HexabitzPlatform/H3BR7x-Hardware/README.md

# H3BR7x-Hardware
Hexabitz 6-Digit 7-Segment Red Display Module Hardware Design
