HexabitzPlatform/H3BR7x-Hardware/Rleased/BOM/H3BR7.xlsx

 |  | www.hexabitz.com info@hexabitz.com |  | Bill Of Materials
Customer | Hexabitz | Revision | 0
Project | Hexabitz Modules | Date | 2024-02-10
Board | 6-Digit 7-Segment Red Display Module (H3BR7) | Notes
Designator | Description | Manufacturer Part Number | Manufacturer | Octopart Url | Quantity
R | Headers & Wire Housings Unshrouded 1 POS T/H | 5-146280-1 | TE Connectivity | https://octopart.com/5-146280-1-te+connectivity+%2F+amp-40259676?r=sp | 1
SWD | Conn Unshrouded Header HDR 3 POS 2.54mm Solder ST Top Entry Thru-Hole Carton | 5-146281-3 | TE Connectivity | https://octopart.com/5-146281-3-te+connectivity+%2F+amp-39745942?r=sp (https://octopart.com/c0603c104k8ractu-kemet-145075?r=sp&s=9bS9ASSwSEqMCE9KBEQZ0g) | 1
R2 | RES SMD 0.0OHM JUMPER 1/10W 0603 | RC0603JR-070RL | YAGEO [VR] | https://octopart.com/rc0603jr-070rl-yageo-1241539?r=sp (https://octopart.com/10tpu4r7msi-panasonic-29487748?r=sp) | 1
R12, R13, R14, R15, R16, R17, R18, R19, R27, R28, R29, R30 | RES SMD 100 OHM 5% 1/10W 0603 | RC0603FR-07100RL | Yageo | https://octopart.com/rc0603fr-07100rl-yageo-55402879?r=sp (https://octopart.com/cl05a106mp8nub8-samsung-68086897?r=sp) | 12
R3 | Thick Film Resistors - SMD 0603 270ohms 5% Tol | ERJ-3GEYJ271V | Panasonic | https://octopart.com/erj-3geyj271v-panasonic-55560546?r=sp (https://octopart.com/rc0603jr-070rl-yageo-1241539?r=sp) | 1
R1, R4, R5, R6, R7, R8, R9, R11, R20, R21, R22, R23, R24, R25, R26 | RES 10 K OHM 5% 0603 | CRCW060310K0JNEB | Vishay | https://octopart.com/crcw060310k0jneb-vishay-46603269 (https://octopart.com/erj-3geyj271v-panasonic-55560546) | 15
C1, C3, C5, C6 | CAP CER 0.1uF 10% x7R 0603 10V | C0603C104K8RACTU | KEMET | https://octopart.com/c0603c104k8ractu-kemet-145075?r=sp&s=9bS9ASSwSEqMCE9KBEQZ0g | 4
C4 | CAP CER 1UF 16V X7R 0805 | CC0805KKX7R7BB105 | YAGEO [VA] | https://octopart.com/cc0805kkx7r7bb105-yageo-8376555?r=sp | 1
C2, C7 | CAP TANT 4.7UF 10V 20% 0805 | 10TPU4R7MSI | Panasonic | https://octopart.com/10tpu4r7msi-panasonic-29487748?r=sp | 2
FB1 | Ind chip Bead Multi-Layer 30 ohms 25% 100MHZ Ferrite 1,5A 0603Punched paper T/R | MMZ1608Y300BTA00 | TDK | https://octopart.com/mmz1608y300bta00-tdk-7906990?r=sp (https://octopart.com/search?q=RC0603FR-0710KL&currency=USD&specs=0) | 1
D1 | Red 0603 130آ° Clear 54 mcd 2 V Surface Mount ChipLED ; | VLMS1300-GS08 (https://octopart.com/manufacturers/wolfspeed) | Vishay | https://octopart.com/vlms1300-gs08-vishay-21709201?r=sp&s=0nXJNjGsSbWwqfqWlZv0EA | 1
D2 | TVS DIODE 3,3V 10,9V SOD323 | CDSOD323-T03SC | BOURNS INC | https://octopart.com/cdsod323-t03sc-bourns-10487153?r=sp | 1
LED1, LED2, LED3, LED4 | LED 3mm RED Collor | TLHK4600 | Vishay | https://octopart.com/tlhk4600-vishay-39410044?r=sp (https://octopart.com/87227-1-te+connectivity-39512052?r=sp) | 4
Q1, Q2, Q3, Q4, Q5, Q6 | Trans GP BJT PNP 40V 0.2A 330mW Automotive 3-Pin SOT-23 T/R | MMBT3906LT1HTSA1 | Infineon | https://octopart.com/mmbt3906lt1htsa1-infineon-21387160?r=sp | 6
Q7, Q8, Q9, Q10, Q11, Q12, Q13, Q14 | Transistor, Bipolar, Si, NPN, General Purpose, VCEO 40VDC, IC 200mA, PD 225mW, SOT-23 | MMBT3904LT1G | ON Semiconductor | https://octopart.com/mmbt3904lt1g-on+semiconductor-3280?r=sp | 8
3661BS | 0.36 inch 6digits RED 8 segment led display Common Anode | 3661BS | China | https://www.aliexpress.com/item/1326420858.html (https://octopart.com/search?q=060300F2201T5E&currency=USD&specs=0) | 1
U1 | MCU 32-Bit ARM Cortex-M0+ RISC 512kByte Flash 1.7V to 3.6V 48-Pin UFQFPN Tray | STM32G0B1CEU6N | STMicroelectronics | https://octopart.com/stm32g0b1ceu6n-stmicroelectronics-116364672?r=sp (https://octopart.com/search?q=MPZ1608S601ATD25&currency=USD&specs=0) | 1
X1 | 8,0000MHZ 33pF SMD MURATA Resonators | CSTNE8M00G550000R0 | Murata | https://octopart.com/cstne8m00g550000r0-murata-91406934?r=sp (https://octopart.com/stm32g0b1ceu6n-stmicroelectronics-116364672?r=sp) | 1
