HexabitzPlatform/H3BR7x-Hardware/Documentation/H3BR7 Schematics.pdf

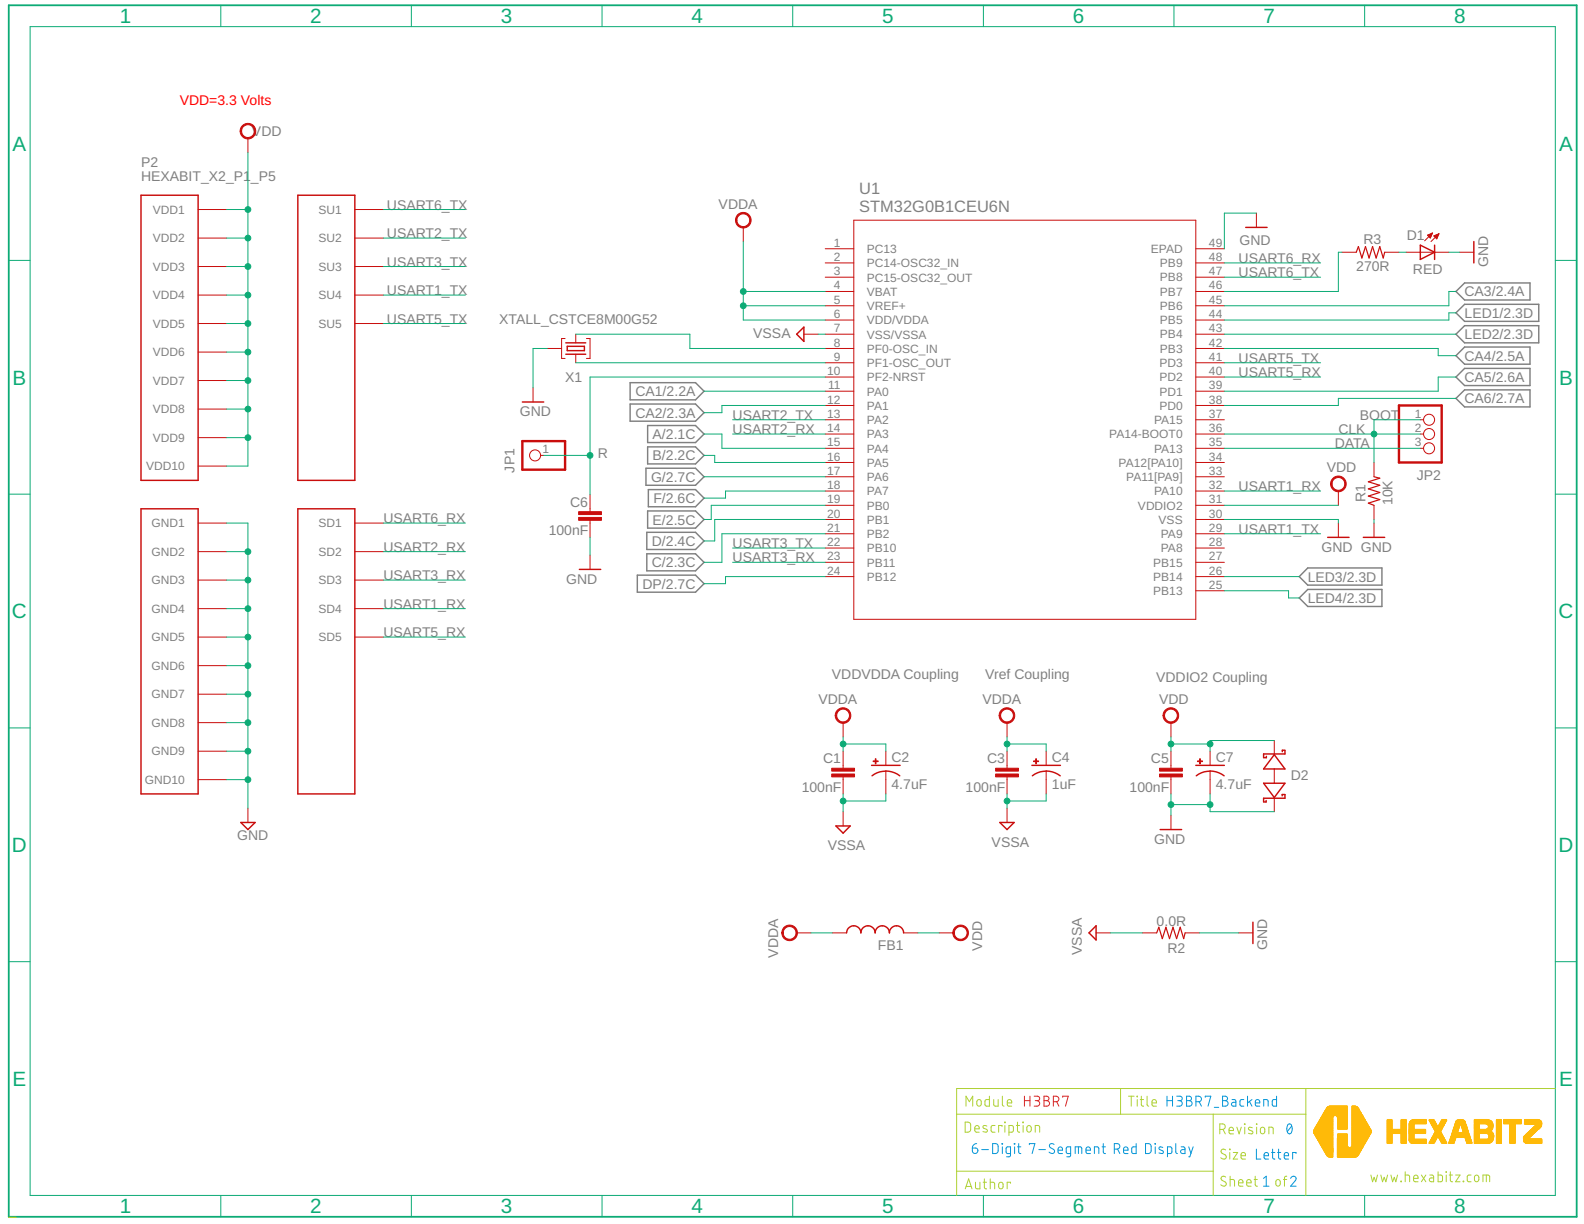
[picture p1: page 1]

5 | 45 PB7
6 | 44 PB6

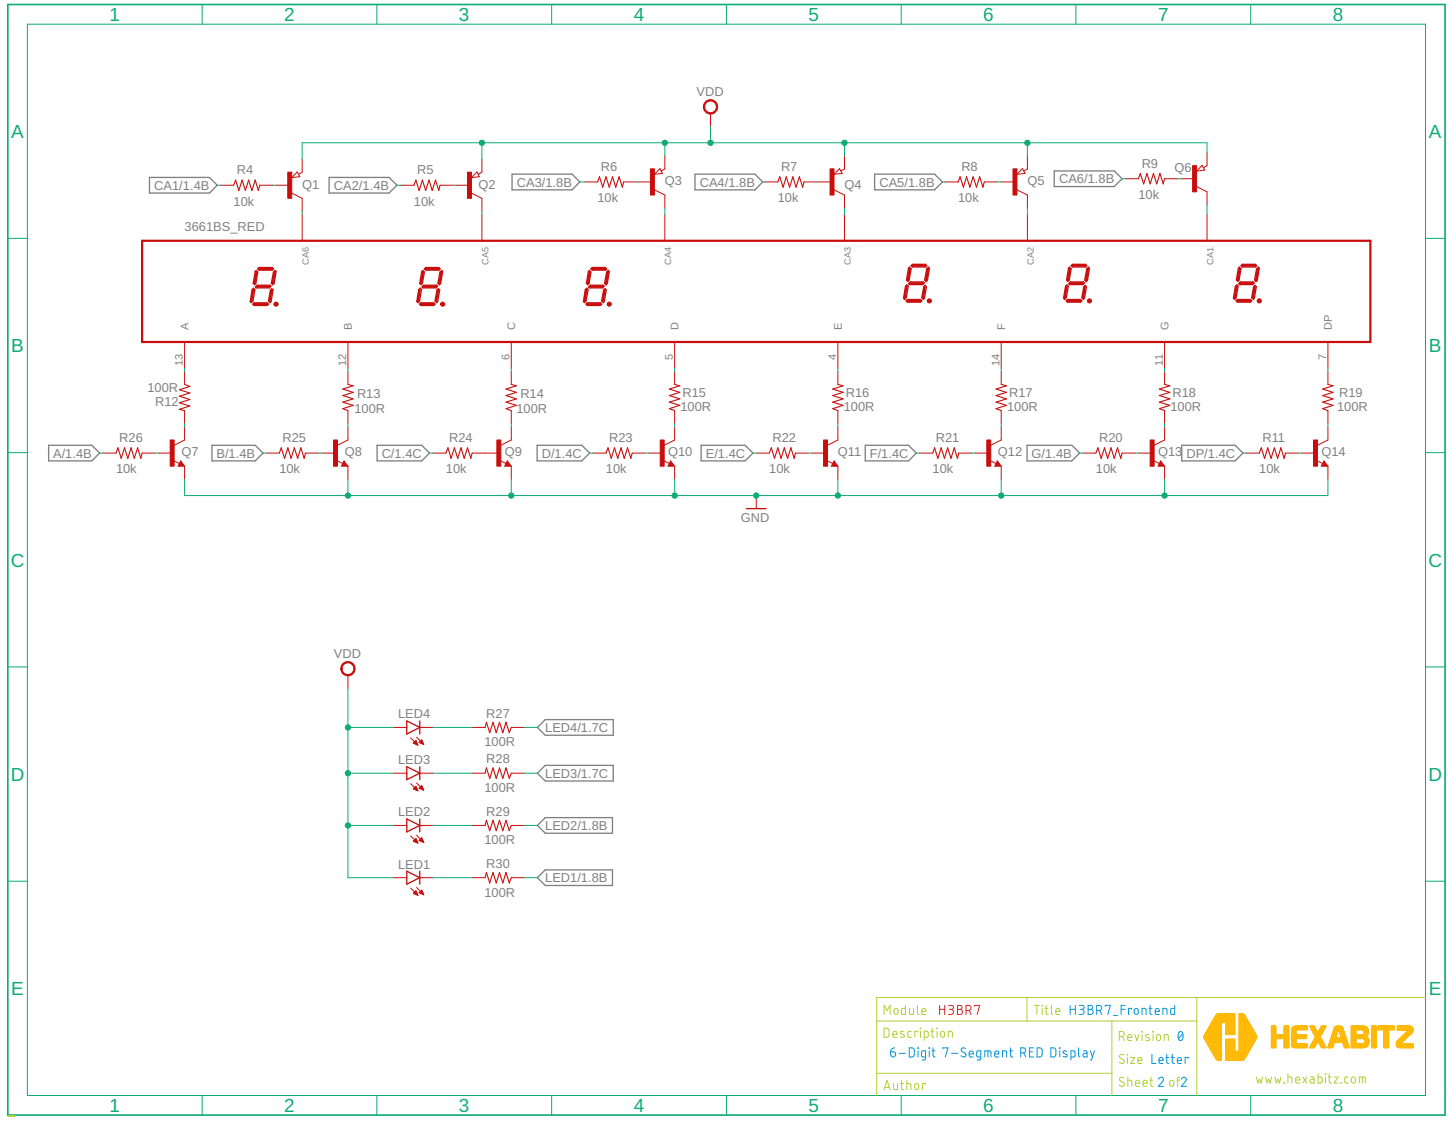
[picture p2: page 2]
