HexabitzPlatform/H3BR7x-Hardware/Design/H3BR7.brd

## EAGLE design Design/H3BR7.brd (2024-04-25)

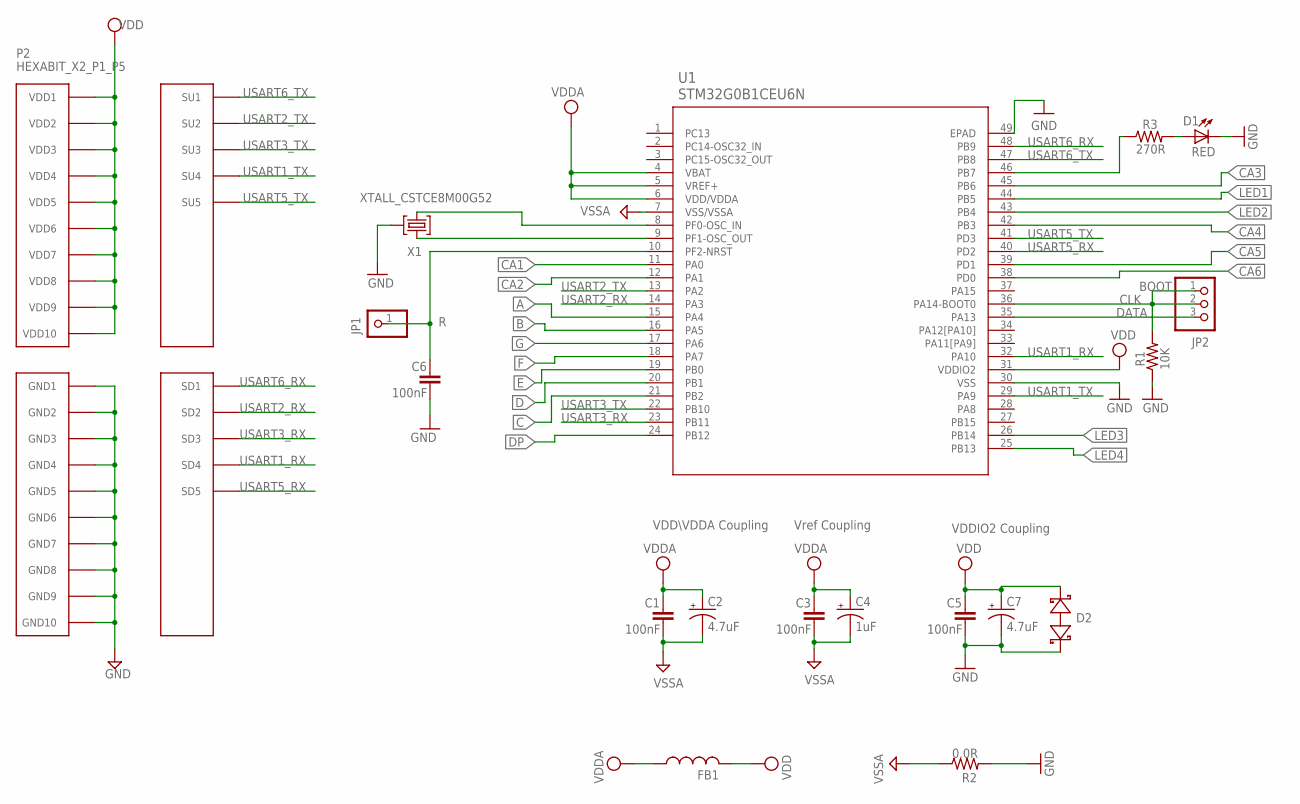
[picture p3: schematic H3BR7.sch, sheet 1]

Parts:
C1, C3, C5, C6: 100nF; C-0603
C2, C7: 4.7uF; C-0805-POL
C4: 1uF; C-0805-POL
D1: RED; VLMS1300-GS08; MPN VLMS1300-GS08
D2: BOURNS_CDSOD323-T03SCBOURNS_CDSOD323-T03SC_0_0; BOURNS_CDSOD323-T03SC_0
FB1: FB-0603
JP1: R; 1X01
JP2: PINHD-1X3; 1X03
P2: HEXABIT_X2_P1_P5; HEXABIT_17.32_X2_P1_P5
R1: 10K; R-0603
R2: 0.0R; R-0603
R3: 270R; R-0603
U1: STM32G0B1CEU6N; HEXABITZ_ICS_QFN_B1CEU6_STM-L
X1: XTALL_CSTCE8M00G52

Connections:
A: U1.15 (PA4); also elsewhere on the board
B: U1.16 (PA5); also elsewhere on the board
C: U1.21 (PB2); also elsewhere on the board
CA1: U1.11 (PA0); also elsewhere on the board
CA2: U1.12 (PA1); also elsewhere on the board
CA3: U1.45 (PB6); also elsewhere on the board
CA4: U1.42 (PB3); also elsewhere on the board
CA5: U1.39 (PD1); also elsewhere on the board
CA6: U1.38 (PD0); also elsewhere on the board
CLK: JP2.1, JP2.2, R1.2, U1.36 (PA14-BOOT0)
D: U1.20 (PB1); also elsewhere on the board
DATA: JP2.3, U1.35 (PA13)
DP: U1.24 (PB12); also elsewhere on the board
E: U1.19 (PB0); also elsewhere on the board
F: U1.18 (PA7); also elsewhere on the board
G: U1.17 (PA6); also elsewhere on the board
GND: C5.2, C6.2, C7.2 (-), D1.C, D2.1 (A), P2.PAD_PD11 (GND1), P2.PAD_PD12 (GND2), P2.PAD_PD13 (GND3), P2.PAD_PD14 (GND4), P2.PAD_PD15 (GND5), P2.PAD_PD16 (GND6), P2.PAD_PD17 (GND7), P2.PAD_PD18 (GND8), P2.PAD_PD19 (GND9), P2.PAD_PD20 (GND10), R1.1, R2.2, U1.30 (VSS), U1.49 (EPAD), X1.P$2 (2); also elsewhere on the board
LED1: U1.44 (PB5); also elsewhere on the board
LED2: U1.43 (PB4); also elsewhere on the board
LED3: U1.26 (PB14); also elsewhere on the board
LED4: U1.25 (PB13); also elsewhere on the board
unnamed: D1.A, R3.2
unnamed: R3.1, U1.46 (PB7)
unnamed: U1.9 (PF1-OSC_OUT), X1.P$1 (1)
unnamed: U1.8 (PF0-OSC_IN), X1.P$3 (3)
unnamed: C6.1, JP1.1, U1.10 (PF2-NRST)
USART1_RX: P2.PAD_PD4 (SD4), U1.32 (PA10)
USART1_TX: P2.PAD_PU4 (SU4), U1.29 (PA9)
USART2_RX: P2.PAD_PD2 (SD2), U1.14 (PA3)
USART2_TX: P2.PAD_PU2 (SU2), U1.13 (PA2)
USART3_RX: P2.PAD_PD3 (SD3), U1.23 (PB11)
USART3_TX: P2.PAD_PU3 (SU3), U1.22 (PB10)
USART5_RX: P2.PAD_PD5 (SD5), U1.40 (PD2)
USART5_TX: P2.PAD_PU5 (SU5), U1.41 (PD3)
USART6_RX: P2.PAD_PD1 (SD1), U1.48 (PB9)
USART6_TX: P2.PAD_PU1 (SU1), U1.47 (PB8)
VDD: C5.1, C7.1 (+), D2.2 (C), FB1.2, P2.PAD_PU11 (VDD1), P2.PAD_PU12 (VDD2), P2.PAD_PU13 (VDD3), P2.PAD_PU14 (VDD4), P2.PAD_PU15 (VDD5), P2.PAD_PU16 (VDD6), P2.PAD_PU17 (VDD7), P2.PAD_PU18 (VDD8), P2.PAD_PU19 (VDD9), P2.PAD_PU20 (VDD10), U1.31 (VDDIO2); also elsewhere on the board
VDDA: C1.1, C2.1 (+), C3.1, C4.1 (+), FB1.1, U1.4 (VBAT), U1.5 (VREF+), U1.6 (VDD/VDDA)
VSSA: C1.2, C2.2 (-), C3.2, C4.2 (-), R2.1, U1.7 (VSS/VSSA)

Notes on the sheet:
Vref Coupling
VDDIO2 Coupling
VDD\VDDA Coupling
BOOT

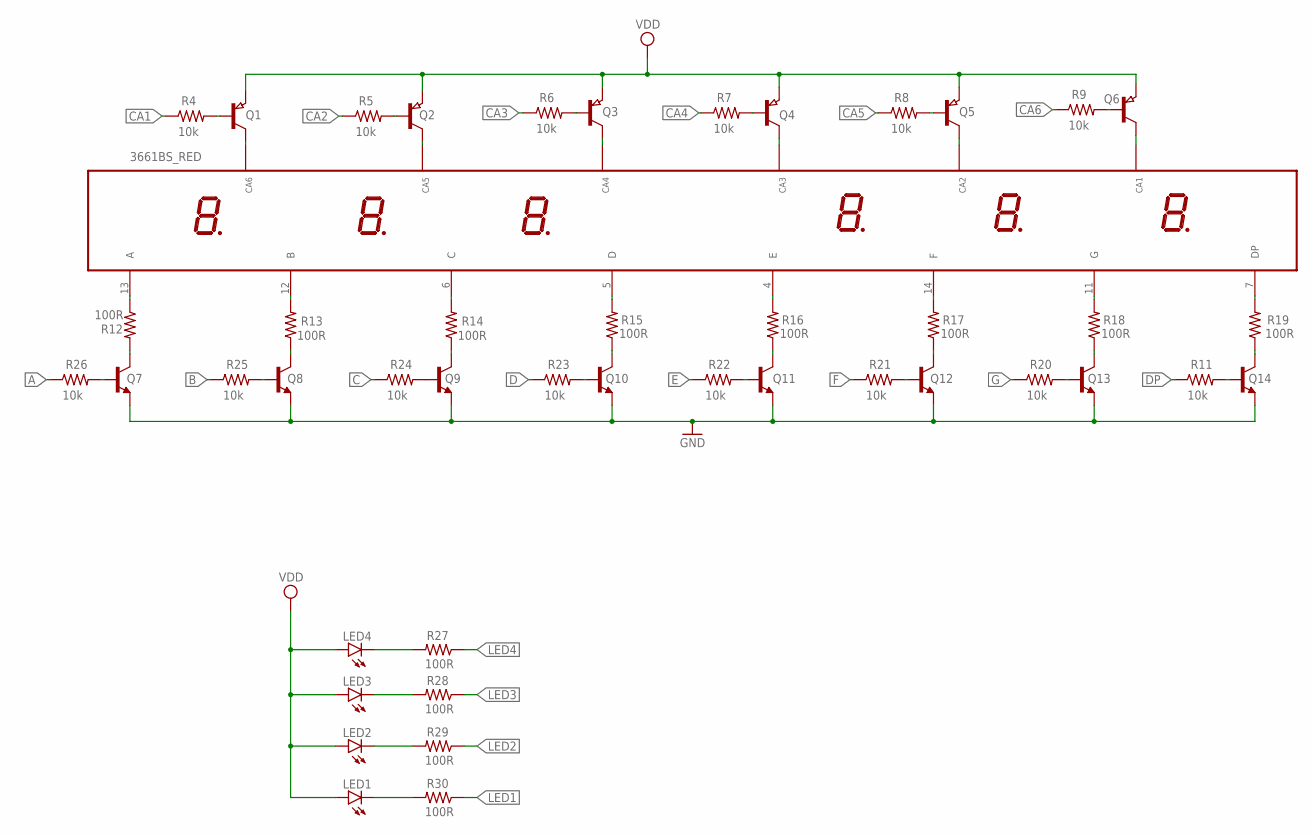
[picture p4: schematic H3BR7.sch, sheet 2]

Parts:
3661BS: 3661BS_RED; 3661BS
LED1, LED2, LED3, LED4: LED-3MM3MM; LED3MM
Q1, Q2, Q3, Q4, Q5, Q6: SEMICON-SMD-IPC_PNP-TRANSISTOR_SOT23; SEMICON-SMD-IPC_SOT23
Q7, Q8, Q9, Q10, Q11, Q12, Q13, Q14: MMBT3904LT1
R4, R5, R6, R7, R8, R9, R11, R20, R21, R22, R23, R24, R25, R26: 10k; R-0603
R12, R13, R14, R15, R16, R17, R18, R19, R27, R28, R29, R30: 100R; R-0603
TRIMBLE-LOGO1: HEXA-LOGO

Connections:
A: R26.1; also elsewhere on the board
B: R25.1; also elsewhere on the board
C: R24.1; also elsewhere on the board
CA1: R4.1; also elsewhere on the board
CA2: R5.1; also elsewhere on the board
CA3: R6.1; also elsewhere on the board
CA4: R7.1; also elsewhere on the board
CA5: R8.1; also elsewhere on the board
CA6: R9.1; also elsewhere on the board
D: R23.1; also elsewhere on the board
DP: R11.1; also elsewhere on the board
E: R22.1; also elsewhere on the board
F: R21.1; also elsewhere on the board
G: R20.1; also elsewhere on the board
GND: Q7.2 (E), Q8.2 (E), Q9.2 (E), Q10.2 (E), Q11.2 (E), Q12.2 (E), Q13.2 (E), Q14.2 (E); also elsewhere on the board
LED1: R30.1; also elsewhere on the board
LED2: R29.1; also elsewhere on the board
LED3: R28.1; also elsewhere on the board
LED4: R27.1; also elsewhere on the board
unnamed: 3661BS.13 (A), R12.1
unnamed: Q7.1 (B), R26.2
unnamed: Q8.3 (C), R13.1
unnamed: 3661BS.6 (C), R14.2
unnamed: Q8.1 (B), R25.2
unnamed: Q9.1 (B), R24.2
unnamed: Q10.1 (B), R23.2
unnamed: Q11.1 (B), R22.2
unnamed: Q12.1 (B), R21.2
unnamed: Q13.1 (B), R20.2
unnamed: Q14.1 (B), R11.2
unnamed: Q10.3 (C), R15.1
unnamed: 3661BS.5 (D), R15.2
unnamed: Q11.3 (C), R16.1
unnamed: Q13.3 (C), R18.1
unnamed: 3661BS.11 (G), R18.2
unnamed: Q7.3 (C), R12.2
unnamed: LED4.K (C), R27.2
unnamed: LED3.K (C), R28.2
unnamed: Q1.1 (B), R4.2
unnamed: Q2.1 (B), R5.2
unnamed: Q3.1 (B), R6.2
unnamed: Q4.1 (B), R7.2
unnamed: Q5.1 (B), R8.2
unnamed: Q6.1 (B), R9.2
unnamed: 3661BS.1 (CA), Q6.3 (C)
unnamed: LED2.K (C), R29.2
unnamed: LED1.K (C), R30.2
unnamed: 3661BS.8 (CA), Q1.3 (C)
unnamed: 3661BS.9 (CA), Q2.3 (C)
unnamed: 3661BS.10 (CA), Q3.3 (C)
unnamed: 3661BS.3 (CA), Q4.3 (C)
unnamed: 3661BS.2 (CA), Q5.3 (C)
unnamed: 3661BS.7 (DP), R19.2
unnamed: Q14.3 (C), R19.1
unnamed: 3661BS.4 (E), R16.2
unnamed: 3661BS.14 (F), R17.2
unnamed: 3661BS.12 (B), R13.2
unnamed: Q12.3 (C), R17.1
unnamed: Q9.3 (C), R14.1
VDD: LED1.A, LED2.A, LED3.A, LED4.A, Q1.2 (E), Q2.2 (E), Q3.2 (E), Q4.2 (E), Q5.2 (E), Q6.2 (E); also elsewhere on the board

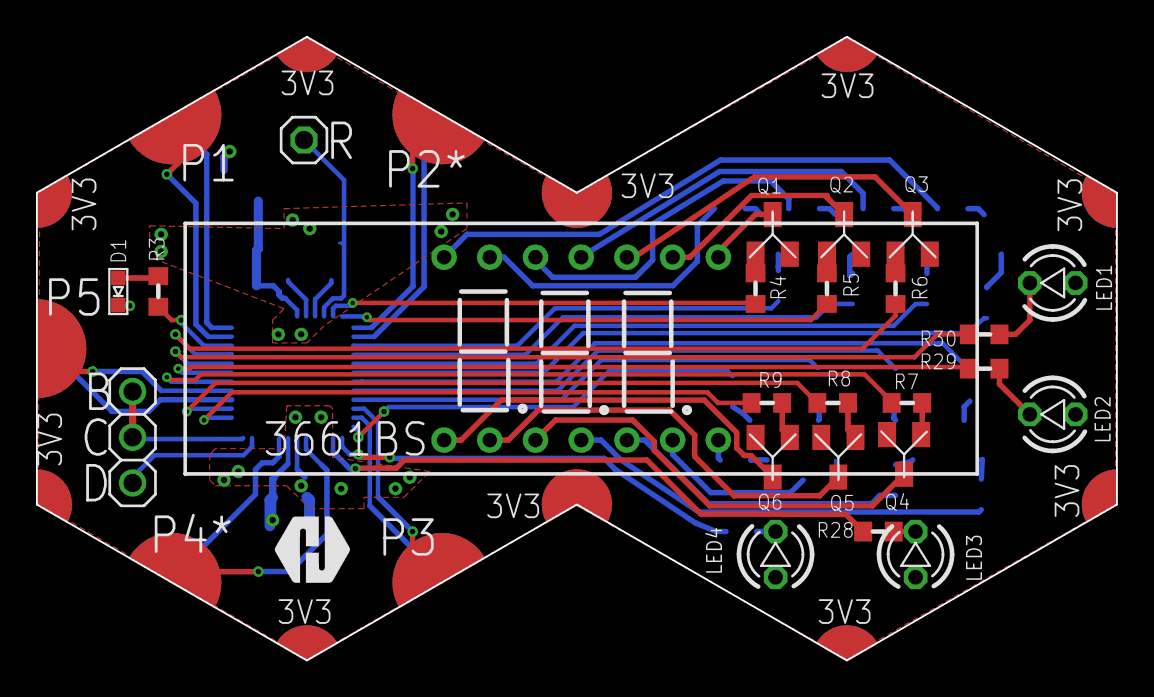
[picture p5: board H3BR7.brd from above]

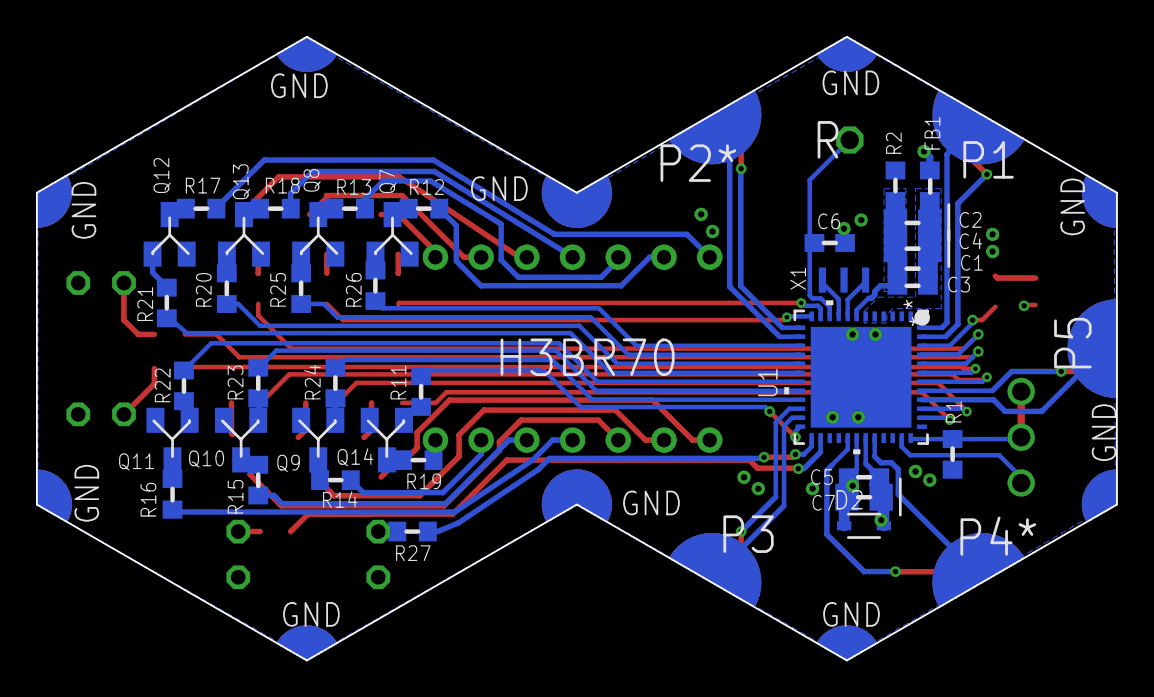
[picture p6: board H3BR7.brd from below]

Board: 2 copper layers, 60.0 x 34.6 mm, 64 parts (38 on the bottom side), 79 nets.
