HexabitzPlatform/H3BR7x-Hardware/(commit log)

2024-02-12 Reviewed Version, all finished.
    [H3BR7.brd, H3BR7.sch, H3BR7.xlsx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]
2024-04-25 -Add Tvs diode -Update the LOGO -Fix the clearance and soldermask layer issues
    [H3BR7.brd, H3BR7.sch, H3BR7.xlsx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]
